gralco/m2_simcom_7100/README.md

# m2_simcom_7100

SIMCom 7100 on a M.2 card.
