gralco/m2_simcom_7100/m2_simcom_7100.pdf

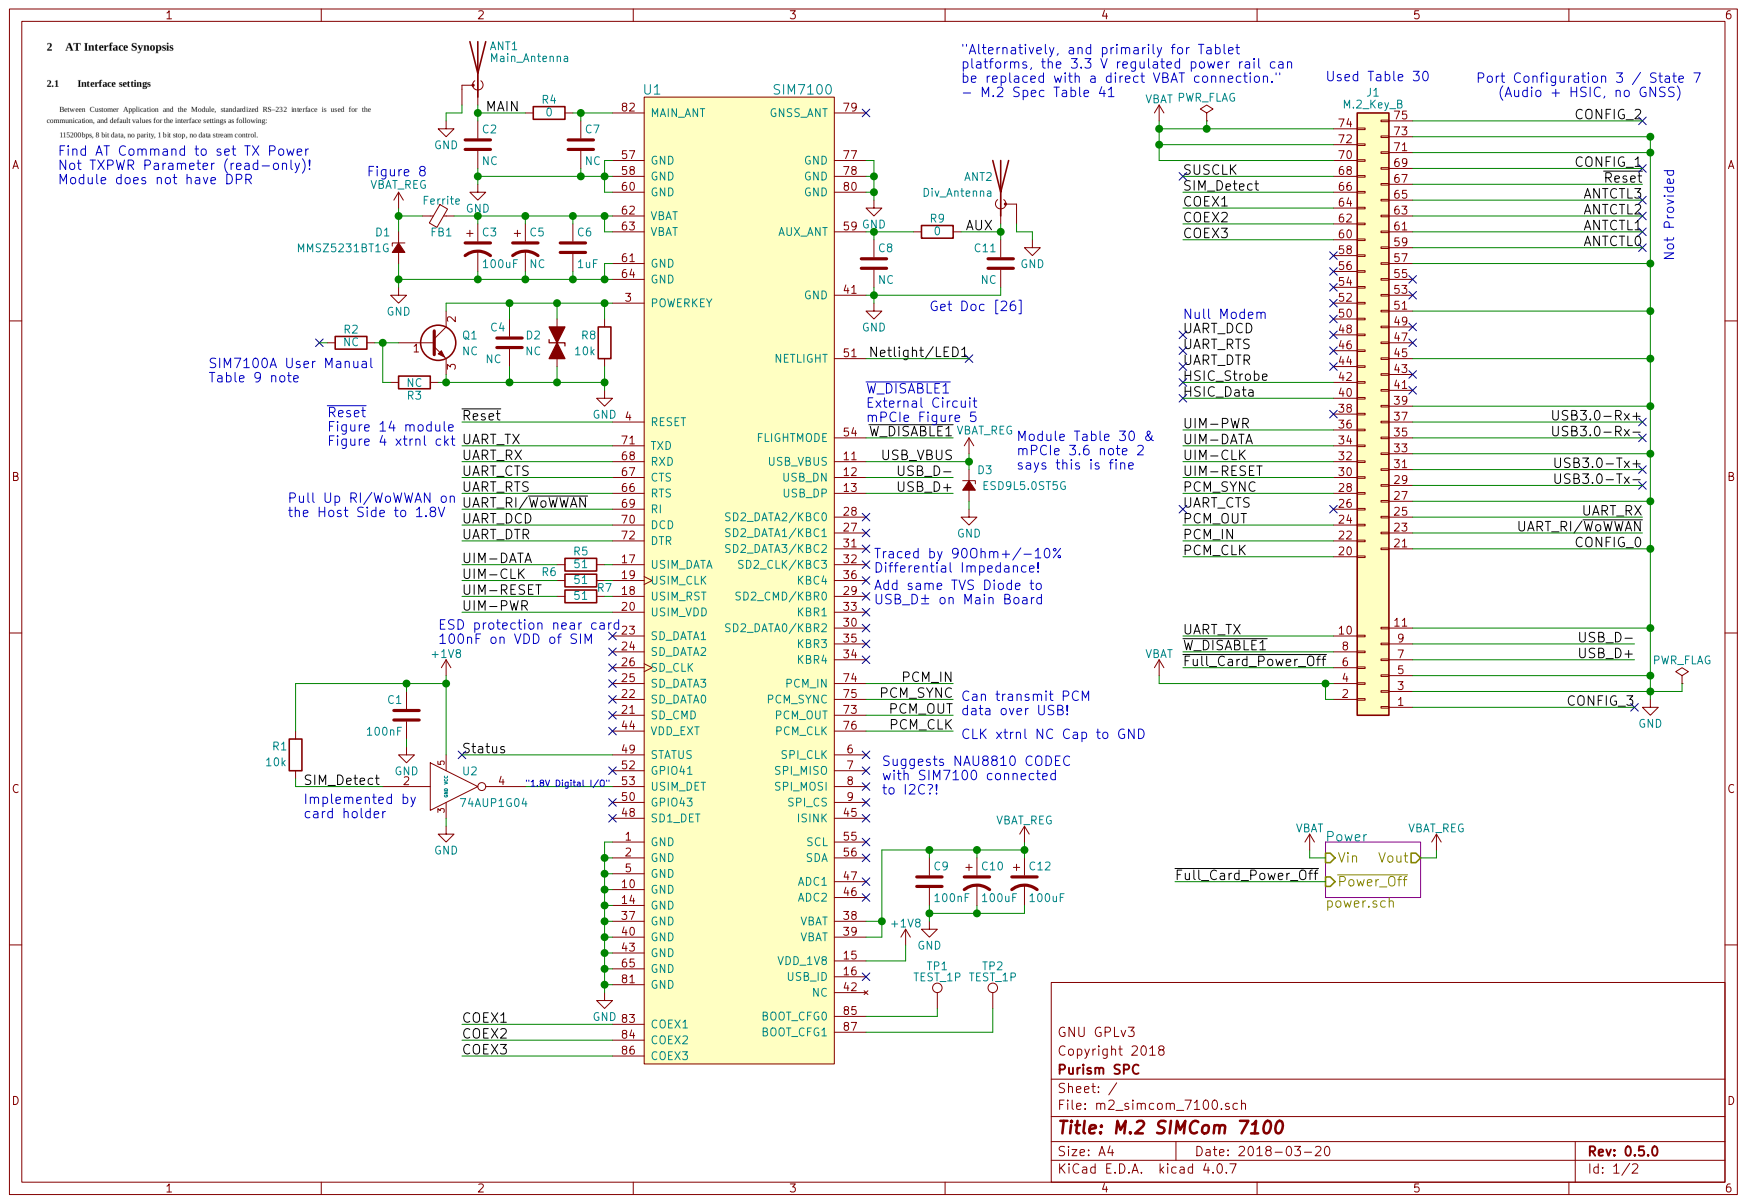
[picture p1: page 1]

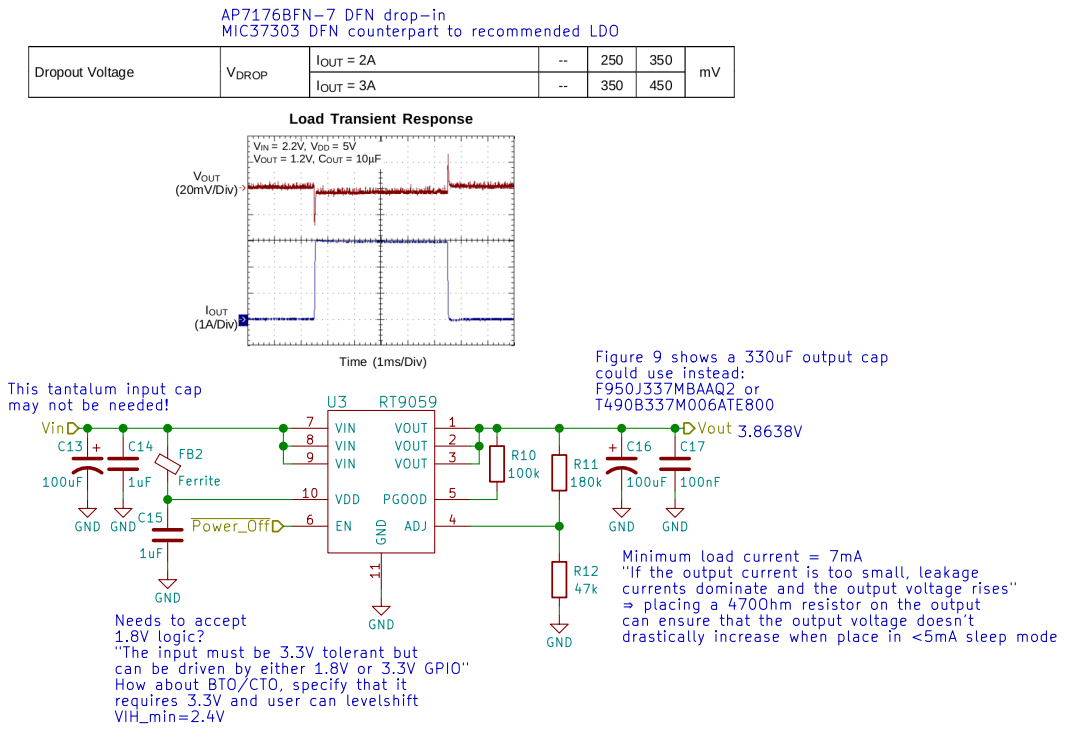
[picture p2: page 2]
