gralco/m2_simcom_7100/m2_simcom_7100.kicad_pcb

## KiCad design m2_simcom_7100.kicad_pcb (2018-03-23)

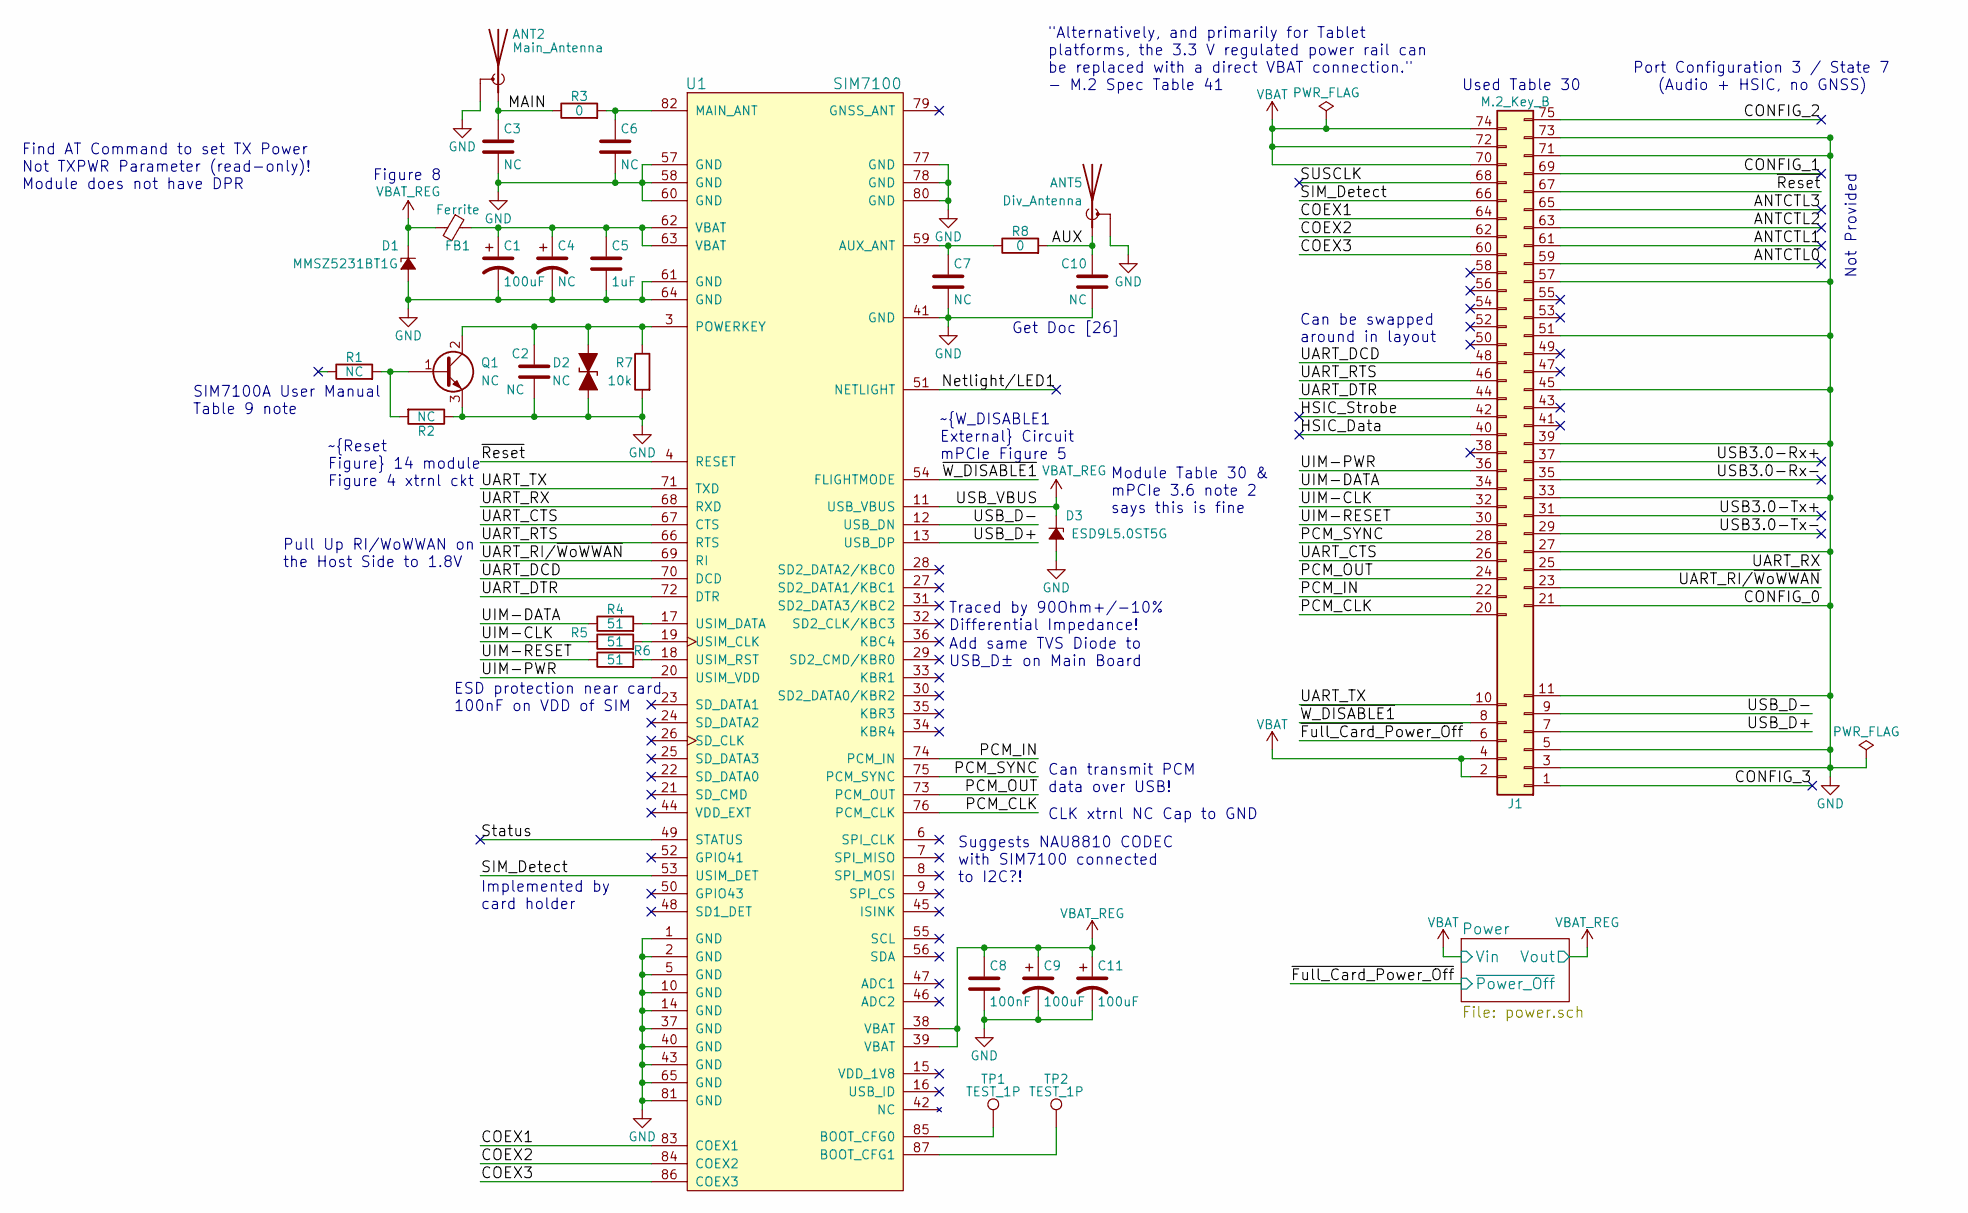
[picture p3: schematic m2_simcom_7100.sch, M.2 SIMCom 7100]

Parts:
ANT2: Main_Antenna; MHF4_20449-001E
ANT5: Div_Antenna; MHF4_20449-001E
C1, C9, C11: 100uF; CP_Tantalum_Case-B_EIA-3528-21_Reflow
C2, C3, C6, C7, C10: NC; C_0603
C4: NC; CP_Tantalum_Case-B_EIA-3528-21_Reflow
C5: 1uF; C_0603
C8: 100nF; C_0603
D1: MMSZ5231BT1G; D_SOD-123
D2: NC; D_0402
D3: ESD9L5.0ST5G; D_SOD-923
FB1: Ferrite; L_0603
J1: M.2_Key_B; M.2_Key_B_Gold_Fingers
Q1: NC; SOT-23
R1, R2: NC; R_0603
R3, R8: 0; R_0603
R4, R5, R6: 51; R_0603
R7: 10k; R_0603
TP1, TP2: TEST_1P; Measurement_Point_Round-SMD-Pad_Small
U1: SIM7100; SIMCom_7100

Connections:
/ANTCTL0: J1.59
/ANTCTL1: J1.61
/ANTCTL2: J1.63
/ANTCTL3: J1.65
/AUX: ANT5.1 (A), C10.1, R8.2
/COEX1: J1.64, U1.83 (COEX1)
/COEX2: J1.62, U1.84 (COEX2)
/COEX3: J1.60, U1.86 (COEX3)
/CONFIG_1: J1.69
/CONFIG_2: J1.75
/CONFIG_3: J1.1
/HSIC_Data: J1.40
/HSIC_Strobe: J1.42
/MAIN: ANT2.1 (A), C3.1, R3.1
/Netlight/LED1: U1.51 (NETLIGHT)
/PCM_CLK: J1.20, U1.76 (PCM_CLK)
/PCM_IN: J1.22, U1.74 (PCM_IN)
/PCM_OUT: J1.24, U1.73 (PCM_OUT)
/PCM_SYNC: J1.28, U1.75 (PCM_SYNC)
/SIM_Detect: J1.66, U1.53 (USIM_DET)
/SUSCLK: J1.68
/Status: U1.49 (STATUS)
/UART_CTS: J1.26, U1.67 (CTS)
/UART_DCD: J1.48, U1.70 (DCD)
/UART_DTR: J1.44, U1.72 (DTR)
/UART_RI/~WoWWAN: J1.23, U1.69 (RI)
/UART_RTS: J1.46, U1.66 (RTS)
/UART_RX: J1.25, U1.68 (RXD)
/UART_TX: J1.10, U1.71 (TXD)
/UIM-CLK: J1.32, R5.1
/UIM-DATA: J1.34, R4.1
/UIM-PWR: J1.36, U1.20 (USIM_VDD)
/UIM-RESET: J1.30, R6.1
/USB3.0-Rx+: J1.37
/USB3.0-Rx-: J1.35
/USB3.0-Tx+: J1.31
/USB3.0-Tx-: J1.29
/USB_D+: J1.7, U1.13 (USB_DP)
/USB_D-: J1.9, U1.12 (USB_DN)
/~Full_Card_Power_Off: J1.6; also elsewhere on the board
/~Reset: J1.67, U1.4 (RESET)
/~W_DISABLE1: J1.8, U1.54 (FLIGHTMODE)
GND: ANT2.2 (Shield), ANT5.2 (Shield), C1.2, C2.2, C3.2, C4.2, C5.2, C6.2, C7.2, C8.2, C9.2, C10.2, C11.2, D1.2 (A), D2.2 (A2), D3.2 (A), J1.3, J1.5, J1.11, J1.21, J1.27, J1.33, J1.39, J1.45, J1.51, J1.57, J1.71, J1.73, Q1.3 (E), R2.1, R7.2, U1.1 (GND), U1.2 (GND), U1.5 (GND), U1.10 (GND), U1.14 (GND), U1.37 (GND), U1.40 (GND), U1.41 (GND), U1.43 (GND), U1.57 (GND), U1.58 (GND), U1.60 (GND), U1.61 (GND), U1.64 (GND), U1.65 (GND), U1.77 (GND), U1.78 (GND), U1.80 (GND), U1.81 (GND); also elsewhere on the board
unnamed: C1.1, C4.1, C5.1, FB1.1, U1.62 (VBAT), U1.63 (VBAT)
unnamed: C2.1, D2.1 (A1), Q1.2 (C), R7.1, U1.3 (POWERKEY)
unnamed: C6.1, R3.2, U1.82 (MAIN_ANT)
unnamed: C7.1, R8.1, U1.59 (AUX_ANT)
unnamed: Q1.1 (B), R1.2, R2.2
unnamed: R4.2, U1.17 (USIM_DATA)
unnamed: R5.2, U1.19 (USIM_CLK)
unnamed: R6.2, U1.18 (USIM_RST)
unnamed: TP1.1, U1.85 (BOOT_CFG0)
unnamed: TP2.1, U1.87 (BOOT_CFG1)
VBAT: J1.2, J1.4, J1.70, J1.72, J1.74; also elsewhere on the board
VBAT_REG: C8.1, C9.1, C11.1, D1.1 (K), D3.1 (K), FB1.2, U1.11 (USB_VBUS), U1.38 (VBAT), U1.39 (VBAT); also elsewhere on the board

Notes on the sheet:
Used Table 30
Port Configuration 3 / State 7 (Audio + HSIC, no GNSS)
ESD protection near card 100nF on VDD of SIM
Not Provided
Traced by 90Ohm+/-10% Differential Impedance!
Find AT Command to set TX Power Not TXPWR Parameter (read-only)! Module does not have DPR
Can be swapped around in layout
Pull Up RI/WoWWAN on the Host Side to 1.8V
Add same TVS Diode to USB_D± on Main Board
Implemented by card holder
~W_DISABLE1 External Circuit mPCIe Figure 5
Can transmit PCM data over USB!
Suggests NAU8810 CODEC with SIM7100 connected to I2C?!
CLK xtrnl NC Cap to GND
Module Table 30 & mPCIe 3.6 note 2 says this is fine
~Reset Figure 14 module Figure 4 xtrnl ckt
Get Doc [26]
SIM7100A User Manual Table 9 note
"Alternatively, and primarily for Tablet platforms, the 3.3 V regulated power rail can be replaced with a direct VBAT connection." - M.2 Spec Table 41
Figure 8

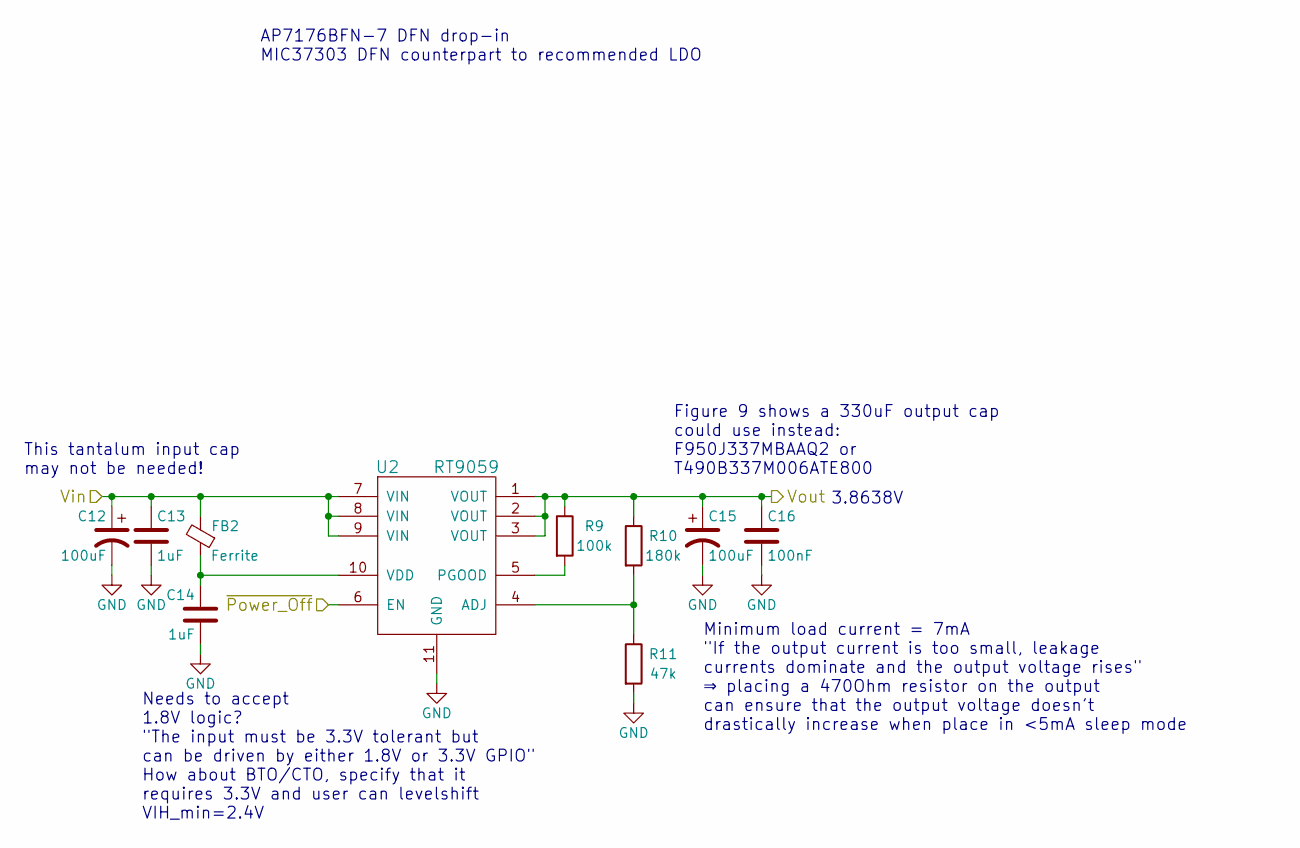
[picture p4: schematic power.sch]

Parts:
C12, C15: 100uF; CP_Tantalum_Case-B_EIA-3528-21_Reflow
C13, C14: 1uF; C_0603
C16: 100nF; C_0603
FB2: Ferrite; L_0603
R9: 100k; R_0603
R10: 180k; R_0603
R11: 47k; R_0603
U2: RT9059; DFN-10-1EP_3x3mm_Pitch0.5mm

Connections:
/~Full_Card_Power_Off: U2.6 (EN); also elsewhere on the board
GND: C12.2, C13.2, C14.2, C15.2, C16.2, R11.2, U2.11 (GND); also elsewhere on the board
unnamed: C14.1, FB2.1, U2.10 (VDD)
unnamed: R9.2, U2.5 (PGOOD)
unnamed: R10.2, R11.1, U2.4 (ADJ)
VBAT: C12.1, C13.1, FB2.2, U2.7 (VIN), U2.8 (VIN), U2.9 (VIN); also elsewhere on the board
VBAT_REG: C15.1, C16.1, R9.1, R10.1, U2.1 (VOUT), U2.2 (VOUT), U2.3 (VOUT); also elsewhere on the board

Notes on the sheet:
Needs to accept 1.8V logic? "The input must be 3.3V tolerant but can be driven by either 1.8V or 3.3V GPIO" How about BTO/CTO, specify that it requires 3.3V and user can levelshift VIH_min=2.4V
Minimum load current = 7mA "If the output current is too small, leakage currents dominate and the output voltage rises" ⇒ placing a 470Ohm resistor on the output can ensure that the output voltage doesn't drastically increase when place in <5mA sleep mode
Figure 9 shows a 330uF output cap could use instead: F950J337MBAAQ2 or T490B337M006ATE800
This tantalum input cap may not be needed!
AP7176BFN-7 DFN drop-in MIC37303 DFN counterpart to recommended LDO
3.8638V

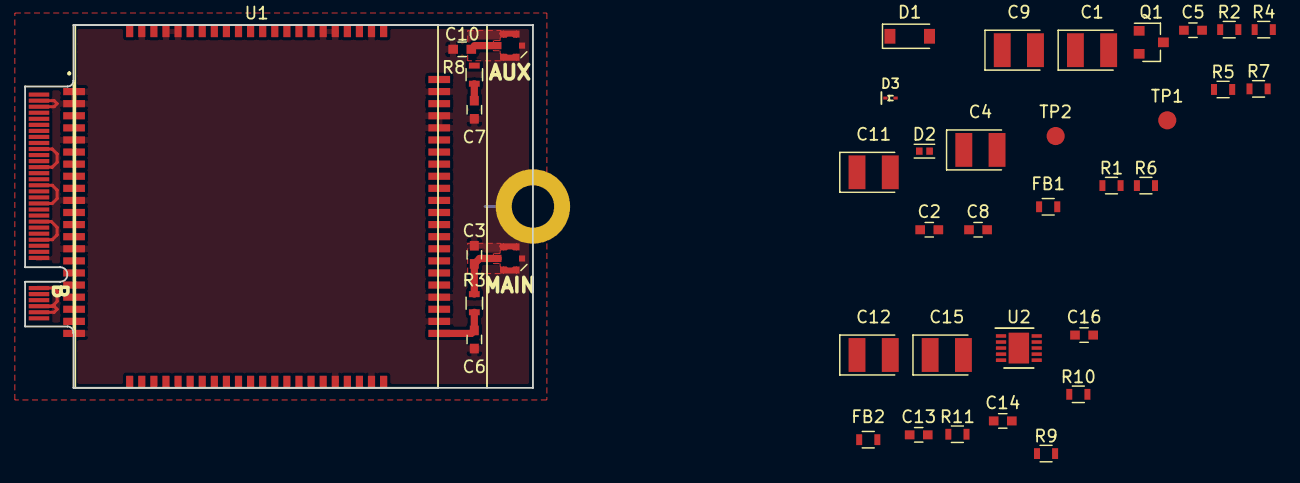
[picture p5: board m2_simcom_7100.kicad_pcb from above]

Board: 2 copper layers, 42.0 x 30.0 mm, 40 parts (0 on the bottom side), 42 nets.
