gralco/m2_simcom_7100/coplanar_waveguide_calculations/closest_true_value_fr406_with_plane.png

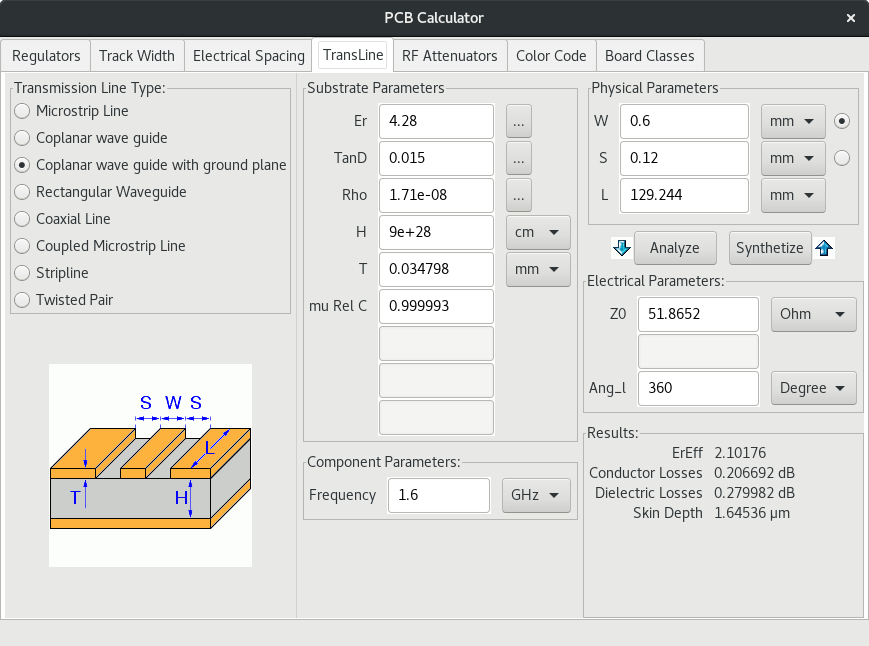
coplanar_waveguide_calculations/closest_true_value_fr406_with_plane.png
