gralco/m2_simcom_7100/coplanar_waveguide_calculations/Screenshot from 2018-03-15 14-44-56.png

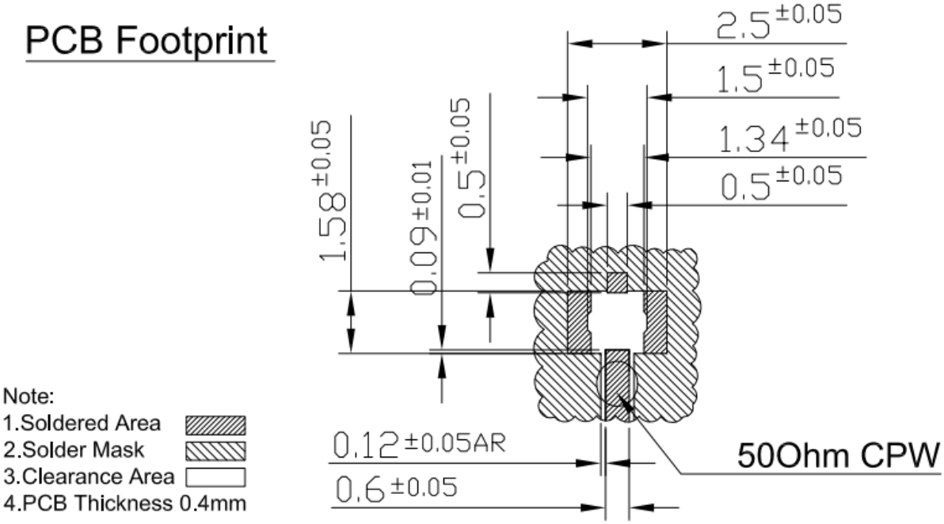
coplanar_waveguide_calculations/Screenshot from 2018-03-15 14-44-56.png
