gralco/m2_simcom_7100/(commit log)

2018-03-13 Add all project files
    [m2_key_b_3042_template.kicad_pcb, m2_key_b_3042_template.sch]
2018-03-15 Include MHF4 coax connectors for the baseband, diversity, and GNSS antennae
    Improved the soldermask and mounting hole.
    Included silkscreen designating the component area.
    Antennae MHF4 coax connectors show what orientation they need to be placed in (chamfer).
    [m2_key_b_3042_template-B.Cu.gbl, m2_key_b_3042_template-B.Mask.gbs, m2_key_b_3042_template-B.Paste.gbp, m2_key_b_3042_template-B.SilkS.gbo, m2_key_b_3042_template-Edge.Cuts.gm1, m2_key_b_3042_template-F.Cu.gtl, m2_key_b_3042_template-F.Mask.gts, m2_key_b_3042_template-F.Paste.gtp]
2018-03-15 Plot schematic to PDF and included title block info
    [m2_key_b_3042_template.kicad_pcb, m2_key_b_3042_template.sch]
2018-03-15 Add MHF4 datasheet to the field values and remove the text reference
    [m2_key_b_3042_template.sch]
2018-03-15 Add coplanar waveguide calculations for the MHF4 antennae tracks
2018-03-16 Include antennae track transmission line impedance calculations which are as close as possible to the expected true value.
    Using the MHF4 recommended 0.6mm track width and 0.12mm space for the 50Ohm CPW.
    Used 4PCB's FR406 relative permitivity and dielectric loss factor values.
    Used slightly less ideal values for the various constants.
2018-03-16 Include copper zones which control the 50Ohm coplanar waveguide for the antennae.
    [m2_key_b_3042_template-B.Cu.gbl, m2_key_b_3042_template-B.Mask.gbs, m2_key_b_3042_template-B.Paste.gbp, m2_key_b_3042_template-B.SilkS.gbo, m2_key_b_3042_template-Edge.Cuts.gm1, m2_key_b_3042_template-F.Cu.gtl, m2_key_b_3042_template-F.Mask.gts, m2_key_b_3042_template-F.Paste.gtp]
2018-03-16 Fix unconnected ground nets on MHF4 connectors.
    DRC no longer complains about the polygon shaped GND pads of the MHF4 footprints.
    [m2_key_b_3042_template-B.Cu.gbl, m2_key_b_3042_template-B.Mask.gbs, m2_key_b_3042_template-B.Paste.gbp, m2_key_b_3042_template-B.SilkS.gbo, m2_key_b_3042_template-Edge.Cuts.gm1, m2_key_b_3042_template-F.Cu.gtl, m2_key_b_3042_template-F.Mask.gts, m2_key_b_3042_template-F.Paste.gtp]
2018-03-16 Work around KiCad Bug #1460787 by making ground filled zones located at the CPW for the antennae the same priority level (0).
    Changing any value in thes "encapsulated" filled zones will cause them to disappear!!!
    Currently DRC is not complaining but it may later on with certain edits.
    [m2_key_b_3042_template-B.Cu.gbl, m2_key_b_3042_template-B.Mask.gbs, m2_key_b_3042_template-B.Paste.gbp, m2_key_b_3042_template-B.SilkS.gbo, m2_key_b_3042_template-Edge.Cuts.gm1, m2_key_b_3042_template-F.Cu.gtl, m2_key_b_3042_template-F.Mask.gts, m2_key_b_3042_template-F.Paste.gtp]
2018-03-16 Include smaller custom 0.508mm diameter 0.254mm drill sized via
    [m2_key_b_3042_template.kicad_pcb]
2018-03-16 Reduce the area of the no-fill zone keeping the bottom ground pour from getting close to the gold finger connector on either edge of the board.
    [m2_key_b_3042_template.kicad_pcb]
2018-03-16 Update the outer filled zone parameters to be closer to the default whilst still giving the recommended 0.25mm clearance away from the gold finger connector.
    [m2_key_b_3042_template-B.Cu.gbl, m2_key_b_3042_template-B.Mask.gbs, m2_key_b_3042_template-B.Paste.gbp, m2_key_b_3042_template-B.SilkS.gbo, m2_key_b_3042_template-Edge.Cuts.gm1, m2_key_b_3042_template-F.Cu.gtl, m2_key_b_3042_template-F.Mask.gts, m2_key_b_3042_template-F.Paste.gtp]
2018-03-16 Add note about signal integrity for routing
    [m2_key_b_3042_template.kicad_pcb]
2018-03-16 Rename all project related files and references to m2_simcom_7100
    [m2_simcom_7100.kicad_pcb, m2_simcom_7100.sch]
2018-03-16 Update the title block to reflect the name change
    [m2_simcom_7100.kicad_pcb, m2_simcom_7100.sch]
2018-03-16 Update the footprint library description to reflect the name change
2018-03-16 Update the footprint nickname and library path to reflect the name change too
2018-03-16 Rename the gerber files to reflect the name change
    [m2_simcom_7100-B.Cu.gbl, m2_simcom_7100-B.Mask.gbs, m2_simcom_7100-B.Paste.gbp, m2_simcom_7100-B.SilkS.gbo, m2_simcom_7100-Edge.Cuts.gm1, m2_simcom_7100-F.Cu.gtl, m2_simcom_7100-F.Mask.gts, m2_simcom_7100-F.Paste.gtp]
2018-03-16 Add SIMCom 7100 footprint
    Pad dimensions might need to change depending on the orientation placed on the M.2 card.
2018-03-17 Update SIMCom 7100 footprint basaed on what its orientation will be on the M.2 card, added silkscreen to denote pin 1
2018-03-19 add SIM7100 schematic symbol
    [m2_simcom_7100.sch]
2018-03-20 Save progress just before replacing pins 10, 23, 25, 26, 44, 46, and 48 with UART pins due to it being Port Configuration 3 / State 7 (no GNSS)
    Pins 10 ~LED1 and 25 DPR (DPR unavailable anyway) being the most practical alternate functions
    Pin 26 was ~W_Disable2 but it was unused anyway, and even if it were it would meant for GNSS anyway (~W_Disable1 takes care of both here)
    [m2_simcom_7100.sch]
2018-03-20 Remove GNSS antenna circuit and place notes regarding external circuit
    Add power sheet for the boost converter for Vbat (3.8V) and Vbus (tie to Vbat)
    [m2_simcom_7100.sch, power.sch]
2018-03-20 Add MIC29302 LDO, VBAT will be used instead of 3.3V in order to reduce power consumption.
    When testing this will require a ~3.8V supply at the M.2 connector!
    [m2_simcom_7100.sch, power.sch]
2018-03-21 Selected which bulk capacitors will be used throughout the design, allowing for a small profile with high capacitance and fast transient response time (low ESR/ESL); also created the respective footp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
    Put in a few notes regarding discrepancies between what the SIM7100 documentation suggests for cap values and what the MIC29302 datasheet says. I chose to go wivalues closer to what SIM7100 suggests but with a lower output cap value due to what photos of the mPCIe module shows. Namely, use of a few TMCUB0J107MTRF 100uF caps throughout the design, using this same cap near the regulator in place of an expensive 330uF one (as suggested in figure 9).
    [m2_simcom_7100.sch, power.sch]
2018-03-22 Assign all footprints and generate netlist
    [m2_simcom_7100.sch, power.sch]
2018-03-22 Fix footprint associations in netlist which are pointing to the wrong library name
    [m2_simcom_7100.kicad_pcb, m2_simcom_7100.sch]
2018-03-22 Swap Main and Div antenna positions
    [m2_simcom_7100.kicad_pcb, m2_simcom_7100.sch]
2018-03-22 Import the netlist and associated footprints into the layout
    [m2_simcom_7100.kicad_pcb]
2018-03-23 Swapping out the MIC29302 4.46mm thick TO-263 LDO with the smaller RT9059 WDFN-10L part which can handle the high current transients in a much more suitable package
    The package is also much cheaper!
    [m2_simcom_7100.kicad_pcb, power.sch]
2018-03-23 Use the RT9059 LDO in the layout instead of the old MIC29302 one
    [m2_simcom_7100.kicad_pcb, m2_simcom_7100.sch, power.sch]
2018-04-12 Add 74AUP1G04 schmitt-triggered inverter to SIM_DET based on the fact that most WWAN M.2 modules expect this to be an active HIGH input
    [m2_simcom_7100.sch, power.sch]
2018-04-13 Make UART interface null modem instead of full modem
    Full modem is unnecessary since the modem can be woken via USB. There's no dedicated DTR, DSR, or DCD lines on the i.MX8M. Generally simpler to implement standard UART (Null Modem).
    [m2_simcom_7100.sch]
