gralco/m2_simcom_7100/(notices)

Notices in the files:
m2_simcom_7100.kicad_pcb:
Copyright 2018
GNU GPLv3
